irfannazril/esp32s3-smart-queueing-system/flowchart/Project-Eldig-Kelompok-3.png

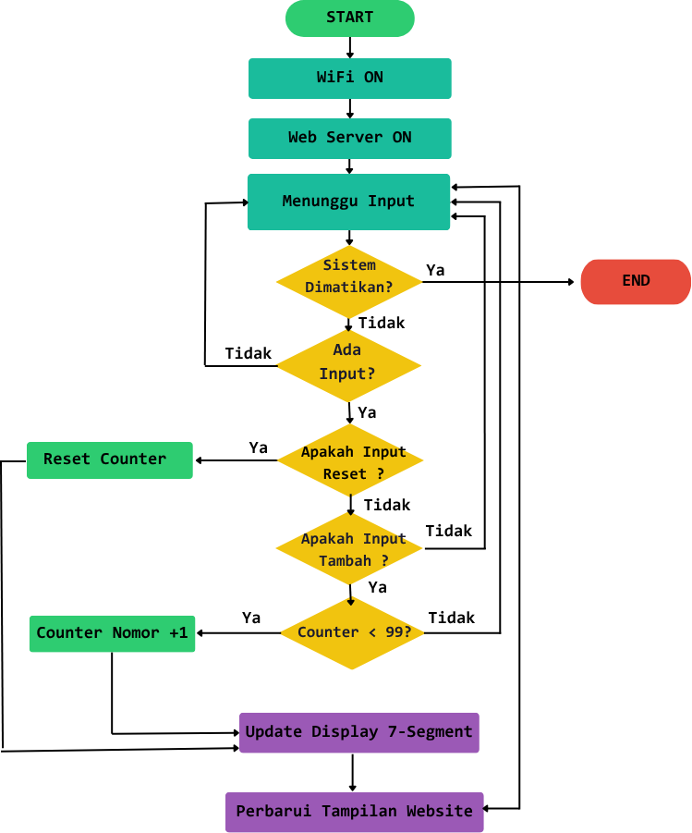
flowchart/Project-Eldig-Kelompok-3.png
