irfannazril/esp32s3-smart-queueing-system/images/Smart-Queueing-System-Front.jpg

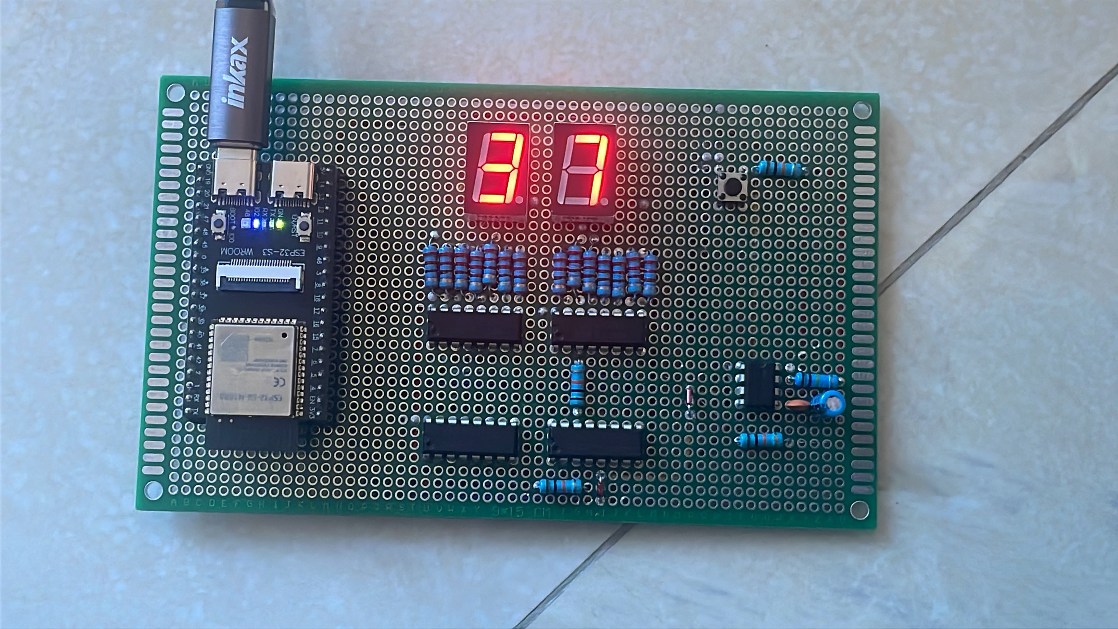
images/Smart-Queueing-System-Front.jpg
