irfannazril/esp32s3-smart-queueing-system/images/Smart-Queueing-System-WebApp.jpg

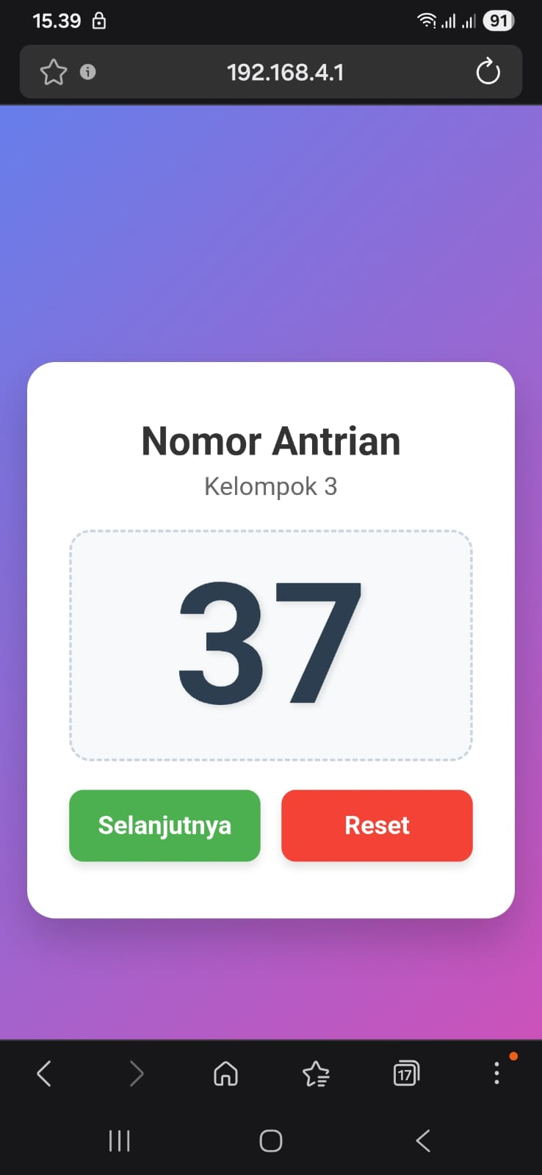
images/Smart-Queueing-System-WebApp.jpg
