irfannazril/esp32s3-smart-queueing-system/(commit log)

2026-06-25 Revise README for Smart Queueing System project
    Updated project description, roles, tools, and challenges for the Smart Queueing System based on ESP32-S3.
2026-06-26 Revise README with updated components and details
    Updated passive components and clarified ESP32-S3 features.
2026-06-26 Revise README with component details and troubleshooting
    Updated descriptions for components and clarified issues faced during assembly. Added images and video links for better documentation.
